Hemisphere-Project/Flipper-FDL19/Docs/plan sources.JPG

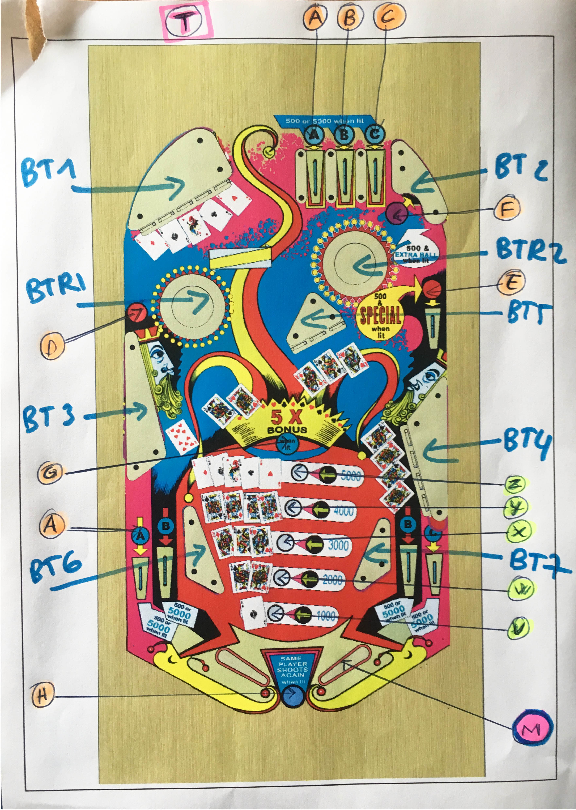
Docs/plan sources.JPG
