Hemisphere-Project/Flipper-FDL19/Docs/timeline.pdf

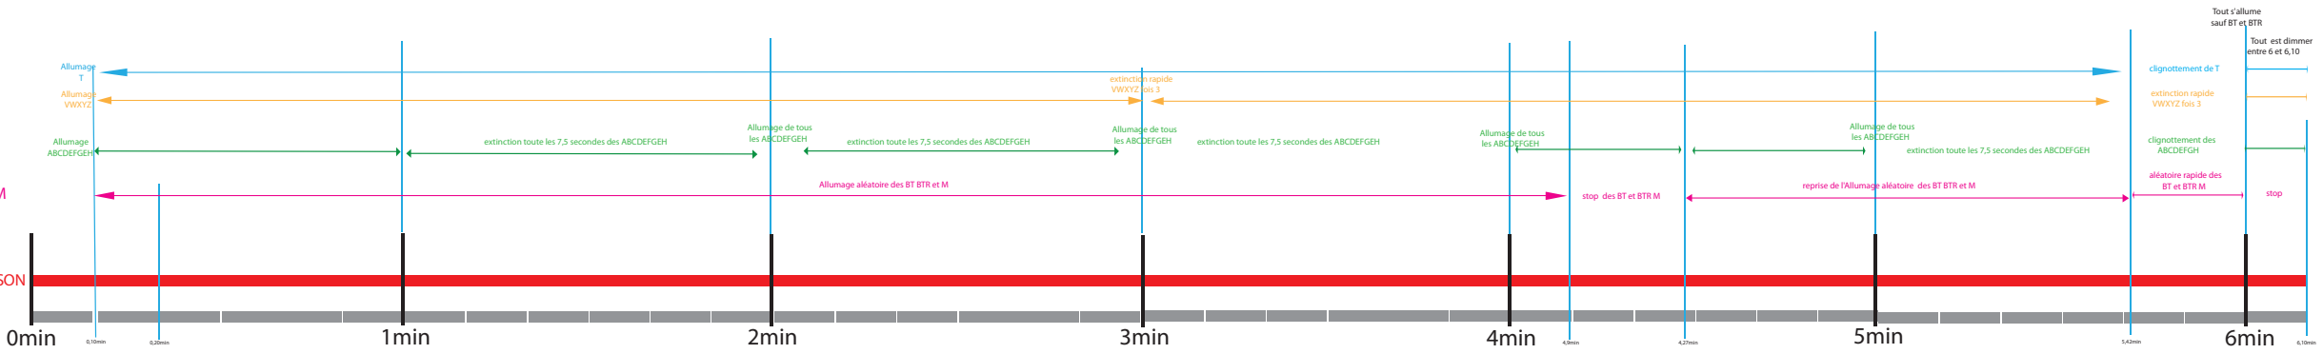
[picture p2: figure]
0min 0,10min; 0,20min; 1min; 2min; 3min; 4min 4,9min; 4,27min; 5min; 5,42min; 6min 6,10min; Allumage ABCDEFGEH; Allumage VWXYZ; Allumage T; Allumage de tous les ABCDEFGEH Allumage de tous les ABCDEFGEH; Allumage de tous les ABCDEFGEH; Allumage de tous; aléatoire rapide des; BT et BTR M; stop stop des BT et BTR M; extinction rapide; VWXYZ fois 3; clignottement de T; clignottement des ABCDEFGH; Tout s'allume sauf BT et BTR; Tout est dimmer entre 6 et 6,10

les ABCDEFGEH extinction toute les 7,5 secondes des ABCDEFGEH

Allumage aléatoire des BT BTR et M | reprise de l'Allumage aléatoire des BT BTR et M

extinction toute les 7,5 secondes des ABCDEFGEH

extinction toute les 7,5 secondes des ABCDEFGEH | extinction toute les 7,5 secondes des ABCDEFGEH

# BANDE SON

# BT BTR M

# les 10 pistes BT BTR M ont un son attribuées

# VWXYZ

T

# Timeline Faites vos jeux
