Hemisphere-Project/Flipper-FDL19/Docs/timeline_J.jpg

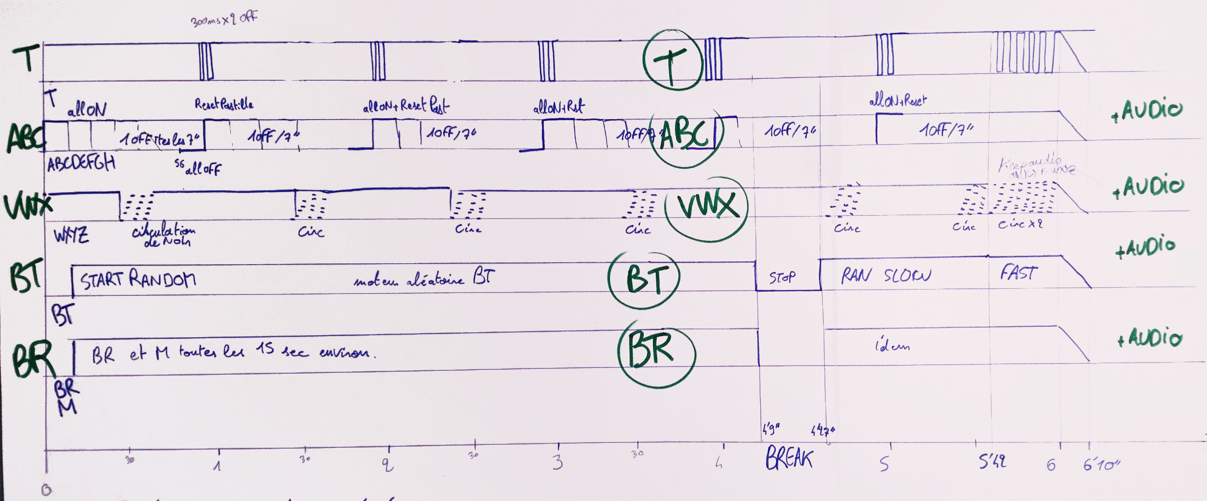
Docs/timeline_J.jpg
