Hemisphere-Project/Flipper-FDL19/Flipper_PCB/Flipper_PCB.kicad_pcb

## KiCad design Flipper_PCB/Flipper_PCB.kicad_pcb (2019-11-21)

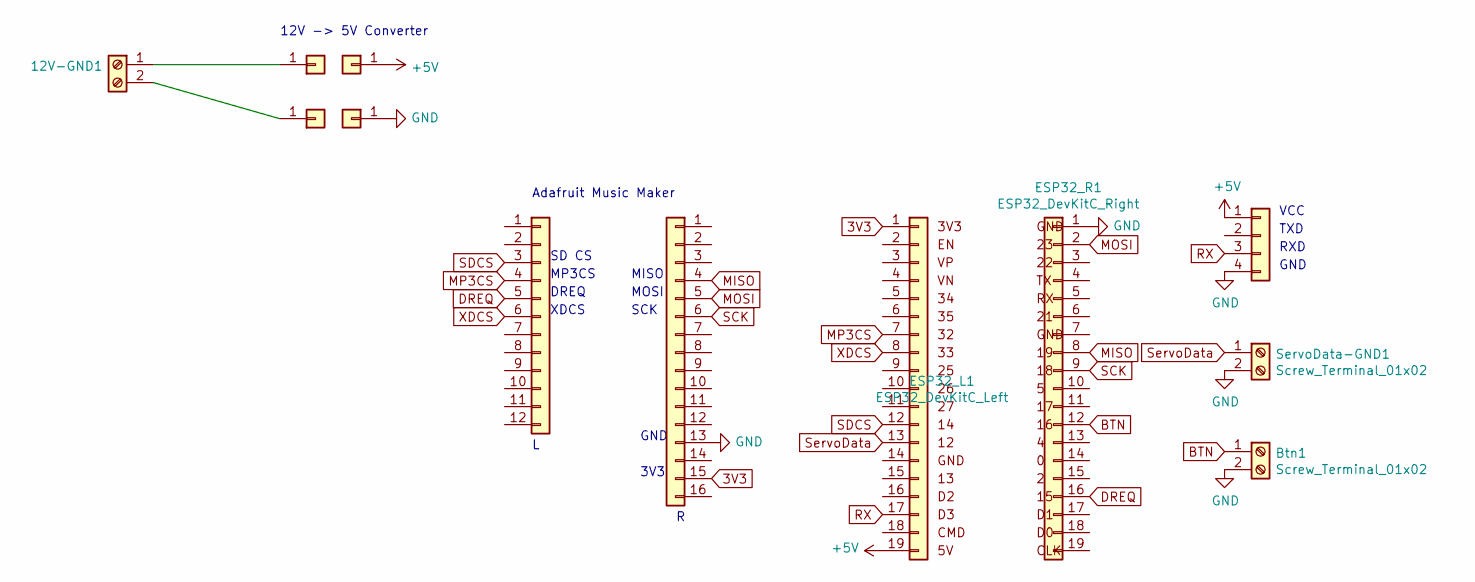
[picture p4: schematic Flipper_PCB.sch]

Parts:
5V1, 12V1: Conn_01x01; PinHeader_1x01_P2.54mm_Vertical
12V-GND1: Screw_Terminal_01x02; TerminalBlock_bornier-2_P5.08mm
Btn1: Screw_Terminal_01x02; TerminalBlock_bornier-2_P5.08mm
ESP32_L1: ESP32_DevKitC_Left; PinSocket_1x19_P2.54mm_Vertical
ESP32_R1: ESP32_DevKitC_Right; PinSocket_1x19_P2.54mm_Vertical
GND1, GND2: Conn_01x01; PinHeader_1x01_P2.54mm_Vertical
MusicMaker_Left1: Conn_01x12; PinSocket_1x12_P2.54mm_Vertical
MusicMaker_Right1: Conn_01x16; PinSocket_1x16_P2.54mm_Vertical
SERIAL1: Conn_01x04; PinSocket_1x04_P2.54mm_Vertical
ServoData-GND1: Screw_Terminal_01x02; TerminalBlock_bornier-2_P5.08mm

Connections:
3V3: ESP32_L1.1, MusicMaker_Right1.15
+5V: 5V1.1, ESP32_L1.19, SERIAL1.1
BTN: Btn1.1, ESP32_R1.12
DREQ: ESP32_R1.16, MusicMaker_Left1.5
GND: Btn1.2, ESP32_R1.1, GND2.1, MusicMaker_Right1.13, SERIAL1.4, ServoData-GND1.2
MISO: ESP32_R1.8, MusicMaker_Right1.4
MOSI: ESP32_R1.2, MusicMaker_Right1.5
MP3CS: ESP32_L1.7, MusicMaker_Left1.4
unnamed: 12V1.1, 12V-GND1.1
unnamed: 12V-GND1.2, GND1.1
RX: ESP32_L1.17, SERIAL1.3
SCK: ESP32_R1.9, MusicMaker_Right1.6
SDCS: ESP32_L1.12, MusicMaker_Left1.3
ServoData: ESP32_L1.13, ServoData-GND1.1
XDCS: ESP32_L1.8, MusicMaker_Left1.6

Notes on the sheet:
MISO
MOSI
SCK
SD CS
MP3CS
DREQ
XDCS
Adafruit Music Maker
VCC
TXD
RXD
GND
12V -> 5V Converter
3V3

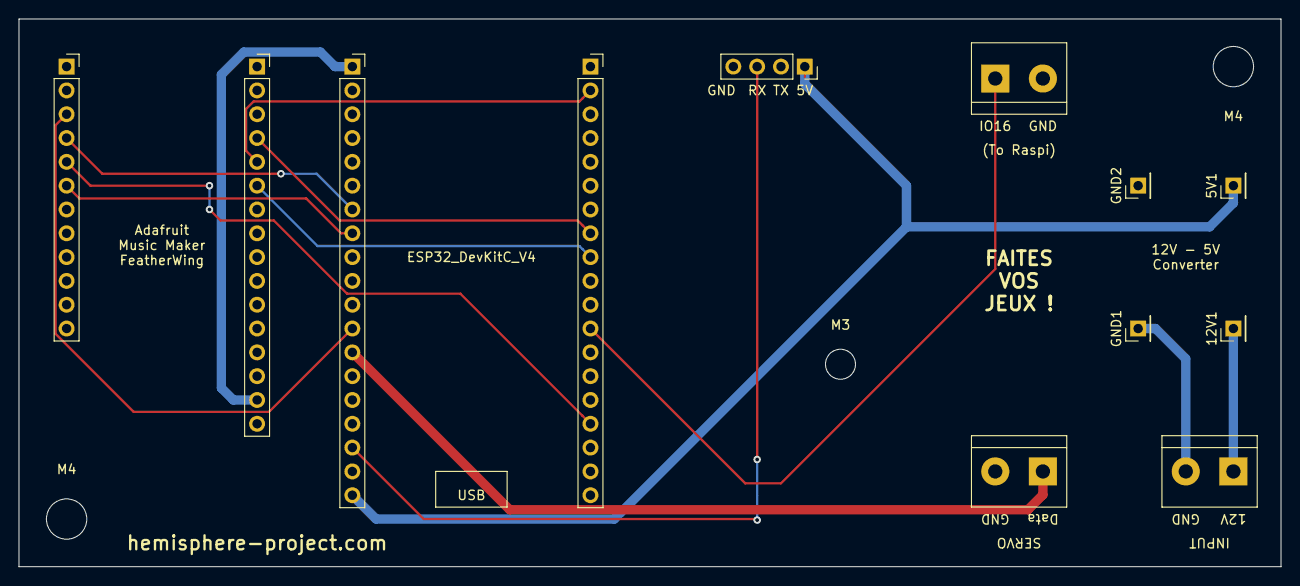
[picture p5: board Flipper_PCB.kicad_pcb from above]

Board: 2 copper layers, 134.6 x 58.4 mm, 15 parts (0 on the bottom side), 15 nets.

Other parts of the board:
M3: MountingHole_3.2mm_M3
M4, M4#2: MountingHole_4.3mm_M4
