Hemisphere-Project/Flipper-FDL19/(commit log)

2019-11-14 pcb ready
    [Flipper_PCB.kicad_pcb, Flipper_PCB.sch]
2019-11-26 motor double
2019-11-28 motor 2nd core
